wagiminator/ATtiny814-USB-PD-Adapter/documentation/USB_PD_Adapter_pic4.jpg

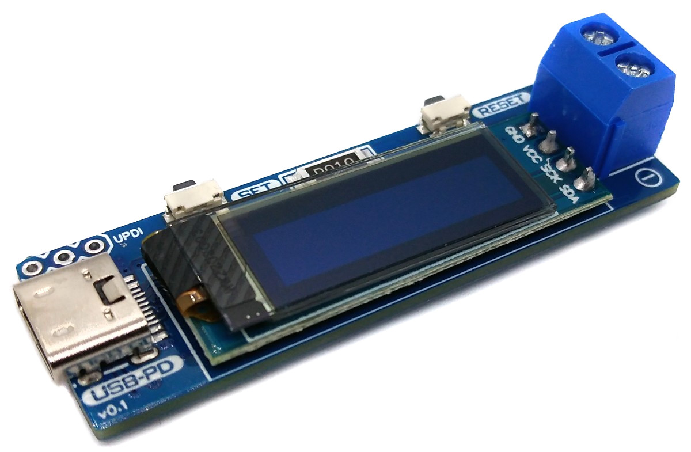
documentation/USB_PD_Adapter_pic4.jpg
