wagiminator/ATtiny814-USB-PD-Adapter/hardware/USB_PD_Adapter_BOM.tsv

ID | Name | Designator | Footprint | Quantity | Manufacturer Part | Manufacturer | Supplier | Supplier Part | Price
1 | 100n | C1,C5,C6 | C_0603 | 3 | CC0603KRX7R9BB104 | YAGEO | LCSC | C14663 | 0.002
2 | 10u | C2 | C_0603 | 1 | CL10A106MA8NRNC | SAMSUNG | LCSC | C96446 | 0.014
3 | 1u | C3 | C_0603 | 1 | CL10A105KB8NNNC | SAMSUNG | LCSC | C15849 | 0.003
4 | 330n | C4 | C_0603 | 1 | 0603B334K250NT | FH | LCSC | C1615 | 0.012
5 | GT-USB-7010ASV | CN1 | USB-C-7010ASV | 1 | GT-USB-7010ASV | G-Switch(品赞) | LCSC | C2988369 | 0.085
6 | KF301-2P | CN3 | KF301-2P | 1 | KF301-5.0-2P | Cixi Kefa Elec | LCSC | C474881 | 0.109
7 | UPDI | CN4 | 210S-3X1/2.54 | 1 | Header2.54mm 1*3P | BOOMELE | LCSC | C49257 | 0.015
8 | SET | KEY1 | SW-SMD_TS24CA | 1 | TS24CA | SHOU HAN | LCSC | C393942 | 0.024
9 | RESET | KEY2 | SW-SMD_TS24CA | 1 | TS24CA | SHOU HAN | LCSC | C393942 | 0.024
10 | OLED 0.91 | OLED1 | I2C OLED 0.91 | 1 | SSD1306 I2C OLED
11 | 10k | R1,R3,R4 | 0603 | 3 | 0603WAF1002T5E | UniOhm | LCSC | C25804
12 | R010 | R2 | 2512 | 1 | 25121WF100MT4E | Uniroyal Elec | LCSC | C127692 | 0.054
13 | ATTINY814-SSN | U1 | SOIC-14_150MIL | 1 | ATTINY814-SSNR | Microchip Tech | LCSC | C182202 | 1.313
14 | CH224K | U2 | ESSOP-10-EP | 1 | CH224K | WCH |  | CH224K
15 | INA219AIDR | U3 | SOP-8_150MIL | 1 | INA219AIDR | TI | LCSC | C138706 | 1.357
16 | 78L33 | U4 | SOT-89-3_BR | 1 | 78L33 | SHIKUES(时科) | LCSC | C2999140 | 0.061
