wagiminator/ATtiny814-USB-PD-Adapter/hardware/USB_PD_Adapter_schematic.pdf

## Microcontroller

## USB Power Delivery

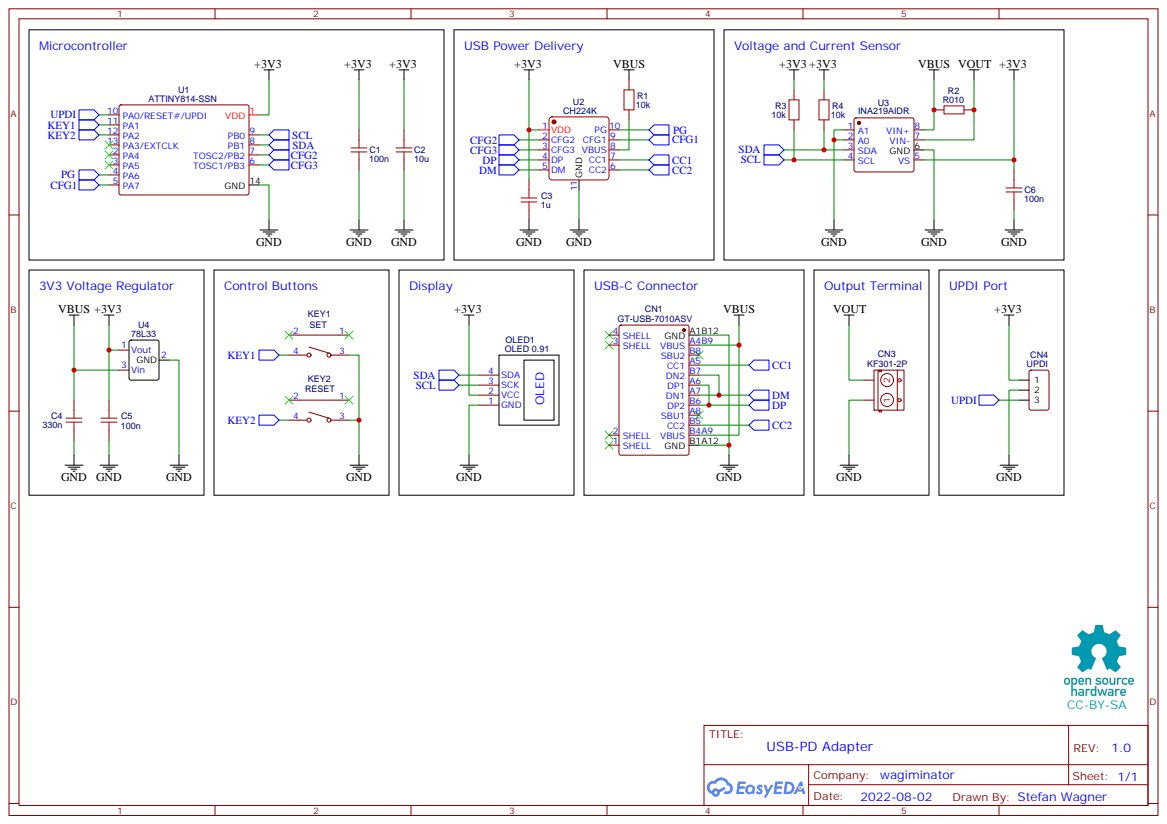
[picture p8: page 1]

Voltage and Current Sensor

Drawn By: Stefan Wagner
