wagiminator/ATtiny814-USB-PD-Adapter/(threads)

Thread 1 (2023-01-06):

Is 100W realistic with this PCB?

spooknik, 2023-01-06:
Hello

Thanks for the projects. I enjoy looking at your work, especially the code.

It does not seem to me the PCB is set up to support 100W (20V at 5A) The VBUS seems to be all routed through one 0.4mm trace.

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

Running this trace at 5A would result in a 75C over ambient temperature rise if the PCB is 2oz copper. ([Tool](https://www.digikey.dk/en/resources/conversion-calculators/conversion-calculator-pcb-trace-width) used for calculations)

Would it be an improvement to wide this trace to 0.6 mm and bring down the other VBUS from the USB-C? In this way, there is 1.0 - 1.2 mm of combined trace and this should handle 5A at an okay temp even with 1oz of copper.

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

wagiminator, 2023-01-06:
Hi and thank you! The adapter is primarily intended for smaller projects. 5A continuous current are certainly borderline for this small device. In principle, any widening of the tracks in the connector area will certainly help. However, the better solution is probably to remove the solder mask on the power track in this area (but not underneath the connector!) and to reinforce the track with additional solder.

spooknik, 2023-01-27:
Thanks for the input 👍

After looking into this a bit, I realize the current shunt resistor should also be changed to something like 0.5mΩ and be around 3W in order to handle 5A of current. The 10mΩ current shunt resistor will only read up to 3.2A I believe.

This line seems to send the config for the INA219 chip: https://github.com/wagiminator/ATtiny814-USB-PD-Adapter/blob/e1635009fa0c9644d1e7a818a29a8e1b2f8267cd/software/USB_PD_Adapter.ino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

What I am looking at is adjusting the PGA (Shunt voltage) to be as high as possible. If I understand it correctly, You have set Bits 11 and 12 to both 1 and 1, so the voltage should be 320 mV? I am still learning the ropes of I2C and just wanted to double check I understand correctly.

The [INA219 Datasheet](https://datasheet.lcsc.com/lcsc/1810181516_Texas-Instruments-INA219AIDR_C138706.pdf) for reference. Page 19, Table 4 for reference.

wagiminator, 2023-01-28:
Hi,
10mΩ are fine, the power dissipation at 5A is I²R = (5A)²*0.01Ω = 250mW (the resistor is rated for up to 1W). The shunt voltage at 5A is calculated I*R = 5A*0.01Ω = 50mV. What you have to do IOT measure up to 5A is setting the PGA gain to /2 (bits 12/11 of INA_CONFIG to 0b0010111111111111).

spooknik, 2023-01-29:
Thanks a lot for the reply, well explained. I was using the wrong formula to calculate power, makes more sense with the right formula 👍

spooknik, 2023-03-06:
Just to conclude, I modified the PCB as show above and exposed the large positive trace through the shunt resistor.

Using my thermal camera I measured the hottest point (shunt resistor) on the PCB at around 36C while running at 100W for about 15 minutes.

Thanks again, it's a handy little tool 🥇

Closed 2023-03-06.

Thread 2 (2023-07-15):

How to find a working powersupply?

Kilsgaard, 2023-07-15:
Hi Stefan
Thanks for all your fantastic projects :-)

Have played with this adapter, and think i have it working it works if i connect it to an USB-C on my computer that i used to power the 3v when i programmed it.

But i cannot find any USB-C supply that can get it to power on.

I know that laptop supplies is not made to be correct PD, but i have tried some that should be real PD.
Like this:
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

Do you have any hint, idea ?

/Graves

wagiminator, 2023-07-16:
This power adapter should work. There is probably a problem with the board or the firmware. Where exactly is the mistake? Does it output no voltage or the wrong voltage? Is anything displayed on the OLED? Is the microcontroller powered?

Kilsgaard, 2023-07-17:
It is a bit weirdly.
Hope I describe this right, I am not that prof at electronics (I am a software guy).

When I connect the board to the USB-C on my compyter, the ATTiny boots.
- I have programmed the ATTiny by powering through my computer.
- It boots up in the software and i can select output power.

When I connect to the PSU:
- The ATTiny does not boot
- I cannot measure any voltage on the ATTiny.

I have not tried to measure on the output yet.
- I have tried to measure on the inputs and cannot measure any voltages.
  But this can also be my lack of electronic skils, not knowing where to start measuring.

-

-

wagiminator, 2023-07-17:
Do I understand this correctly, if you connect the board to your computer via USB-C then it works, but if you connect it to the power adapter then it doesn't work? Is the CH224K soldered properly (especially the bottom of the chip must be soldered to the corresponding pad on the board)?

Thread 4 (2023-11-04):

Is this useful as lab PSU?

elektrinis, 2023-11-04:
I have a 30V5A "analogue" lab PSU that's 20 years old and is bulky, inconvenient to store and a pain to hook up every once in a while I use it. By "lab PSU" it means that it has a really fast current limiting: for example, if set to 30V and 2A, and suddenly connected to a 12V battery, it limits the current properly (without overshoot), and it keeps working, charging the battery.

Knowing about QC3 and above versions ability to set voltage, I started my search for a smart QC decoy that would act as a smart lab PSU and I could store it in my small drawer, where I keep my TS80P (USB) soldering iron as well. An I have landed on this project. It is the closest thing I've found so far, but not quite there yet.

Some devices have appeared recently, like [this one](https://lab401.com/products/pocket-usb-power-supply), but after testing a couple of chinese units (not the one from my link, but I don't expect anything else) I quickly realized they are not capable of doing proper current limiting - they just crash if sudden current spike happens (i.e. in above example).
From your experience, can a standard 65-100W laptop brick limit the current, and be FAST at it?

And I think we would need QC5 to get >100W? Are there any chips for that, or perhaps it is possible to emulate the commands in software, like some keyboard and serial AVR solutions were done back in the day? For example there is [arduino code](https://www.arduino.cc/reference/en/libraries/qc3control/) for QC3, so the chinese chip could probably be discarded.

An alternative would be to add a couple of opamps and a beefy bipolar transistor and run it in linear mode, with the USB PSU running just a tad higher than set voltage, to keep the BJT from overheating. Then, if current limiting is detected, the PSU should be commanded to lower its voltage quickly to keep the BJT happy. This is how some old school "efficient" audio amplifiers worked before class D took over.

Anyone looking, or even found a thing like this I could just buy?
Or we could just go in to developing this. I have enough knowledge to do it all, but I'm short on time, big time. If someone would be willing to do the firmware and routing, I could come up with the analog power stage to make this happen.

wagiminator, 2023-11-04:
Hi, I don't think this is a reasonable replacement for a lab power supply (nor should it be). On the one hand, the selection of output voltages is limited, and on the other hand, it has no current limit or robust short-circuit protection.

elektrinis, 2023-11-04:
Thanks for quick response. Anyway I'm available to participate in a lab psu project, if anyone is interested.

Thread 5 (2023-11-04):

Maybe ditch the CH224K?

elektrinis, 2023-11-04:
Supply chain issues of covid years and my 20+ years experience in electronics have taught me that it is wise not to develop a product around someone else's proprietary product, that could go obsolete, disappear or become difficult to get. Huge problems, on top of it costing money. So the chip could probably be discarded?
According to this [arduino code for QC3](https://www.arduino.cc/reference/en/libraries/qc3control/), it is possible to interface the USB directly, completely ditching the chip. Implementing this in code would possibly allow future upgrades for QC4 and QC5, that offer power levels above 100W.
Anyone tried this?

wagiminator, 2023-11-04:
Hi, please understand that my projects are mainly designed to experiment with interesting chips (or other components). In this case it was the CH224K, which is quite new and far from obsolete. So it doesn't make sense for me to leave out the CH224K if I want to experiment with it. In addition, the focus of this project is clearly USB-PD, QC doesn't actually interest me at all and I think it's on a declining path anyway. As far as I know, there is no software implementation of USB-PD for AVR. Of course, this is all my subjective point of view, but as a hobbyist it is the relevant one for me, since I don't have to develop for others.
